phorton1/Arduino-bilgeAlarm/docs/drawings/bilge2.jpg

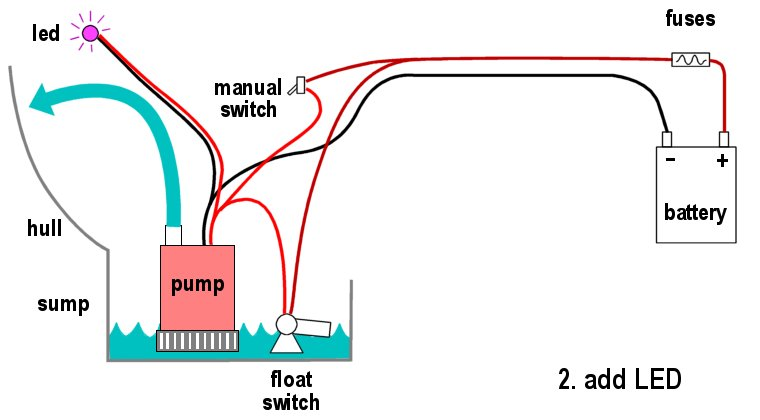
docs/drawings/bilge2.jpg
