phorton1/Arduino-bilgeAlarm/docs/drawings/bilge3.jpg

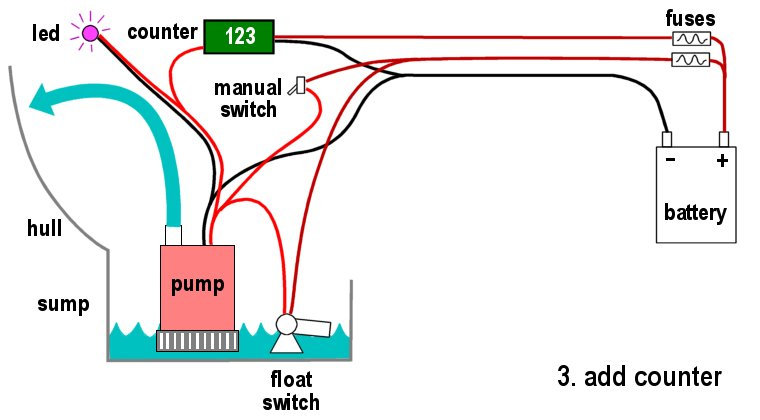
docs/drawings/bilge3.jpg
