phorton1/Arduino-bilgeAlarm/docs/drawings/bilge4.jpg

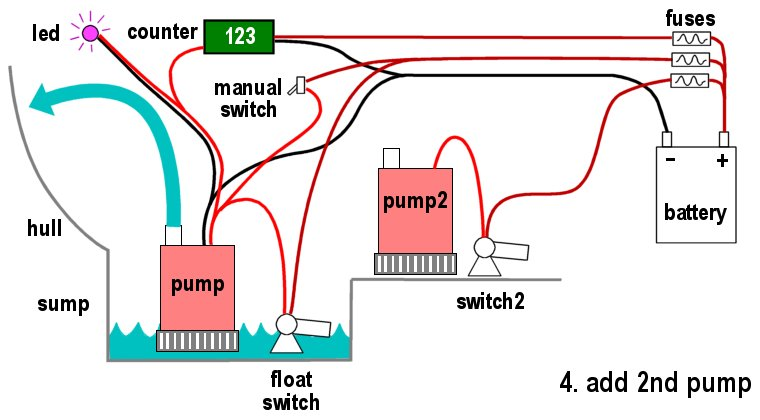
docs/drawings/bilge4.jpg
