phorton1/Arduino-bilgeAlarm/docs/lightburn/face.dxf

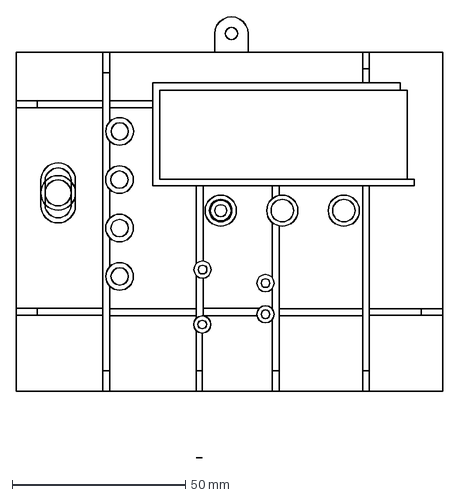
[picture p13: CAD file, 2023-01-15]
docs/lightburn/face.dxf
123.2 x 127.7 mm
