phorton1/Arduino-bilgeAlarm/docs/prusa/alarm_support.3mf

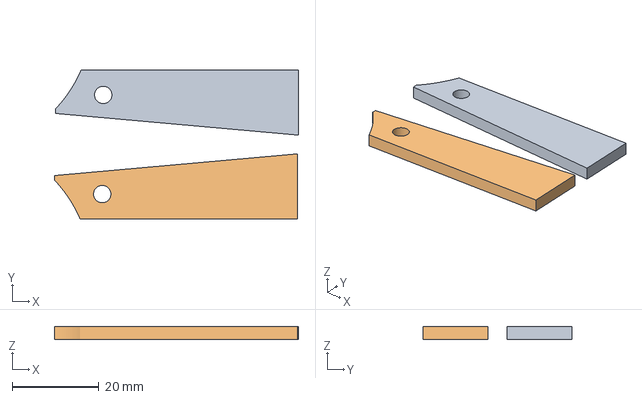
[picture p14: CAD file, 2023-01-15]
docs/prusa/alarm_support.3mf
56.2 x 34.3 x 3.00 mm
alarm_support.stl x 2
