phorton1/Arduino-bilgeAlarm/docs/stl/button.stl

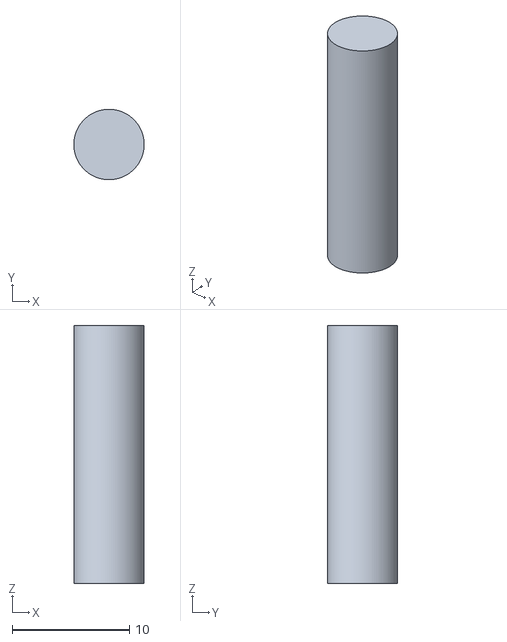
[picture p15: CAD file, 2023-01-15]
docs/stl/button.stl
6.00 x 6.00 x 22.0
