phorton1/Arduino-bilgeAlarm/docs/prusa/led_lens.3mf

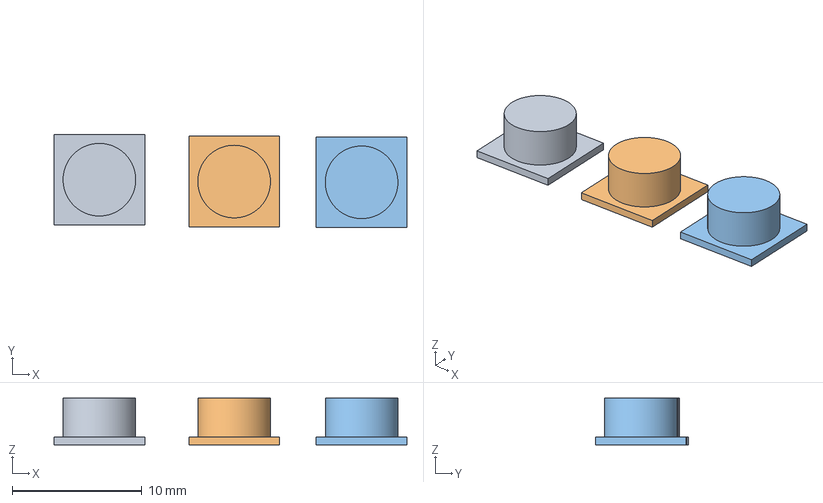
[picture p16: CAD file, 2023-01-15]
docs/prusa/led_lens.3mf
27.2 x 7.20 x 3.60 mm
led_lens.stl x 3
