phorton1/Arduino-bilgeAlarm/docs/stl/led_lens.stl

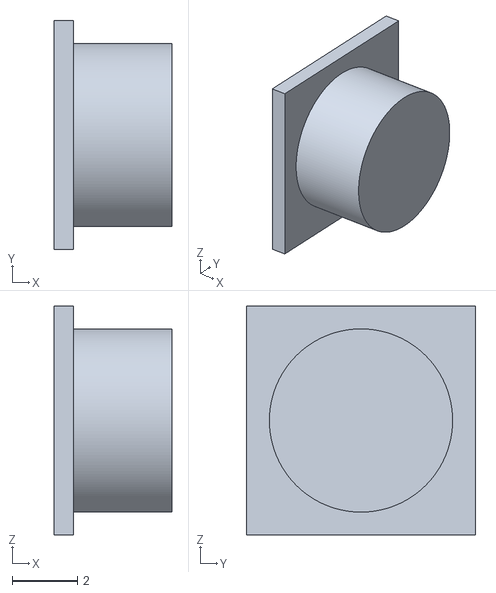
[picture p17: CAD file, 2023-01-15]
docs/stl/led_lens.stl
3.60 x 7.00 x 7.00
