phorton1/Arduino-bilgeAlarm/docs/prusa/led_body.3mf

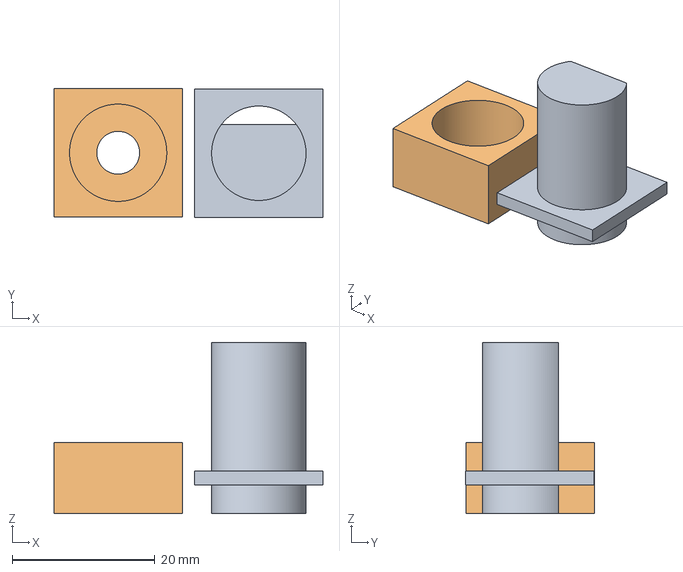
[picture p18: CAD file, 2023-01-15]
docs/prusa/led_body.3mf
37.7 x 18.1 x 24.0 mm
led_body.stl
led_cap.stl
