phorton1/Arduino-bilgeAlarm/docs/stl/usb_mount.stl

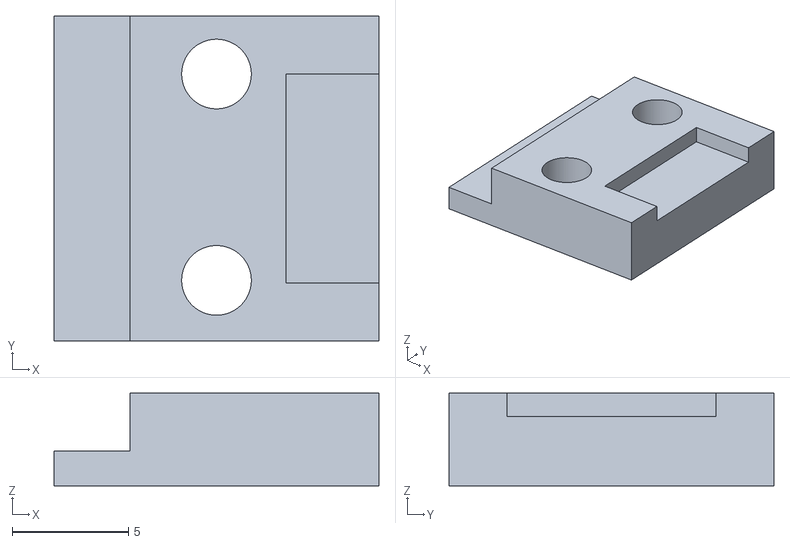
[picture p19: CAD file, 2023-01-15]
docs/stl/usb_mount.stl
14.0 x 14.0 x 4.00
