phorton1/Arduino-bilgeAlarm/docs/prusa/base.3mf

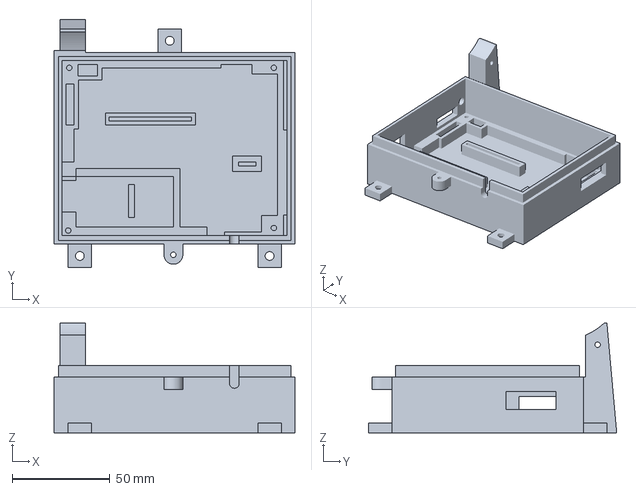
[picture p20: CAD file, 2023-01-15]
docs/prusa/base.3mf
123.2 x 127.0 x 56.0 mm
