phorton1/Arduino-bilgeAlarm/docs/prusa/toppers.3mf

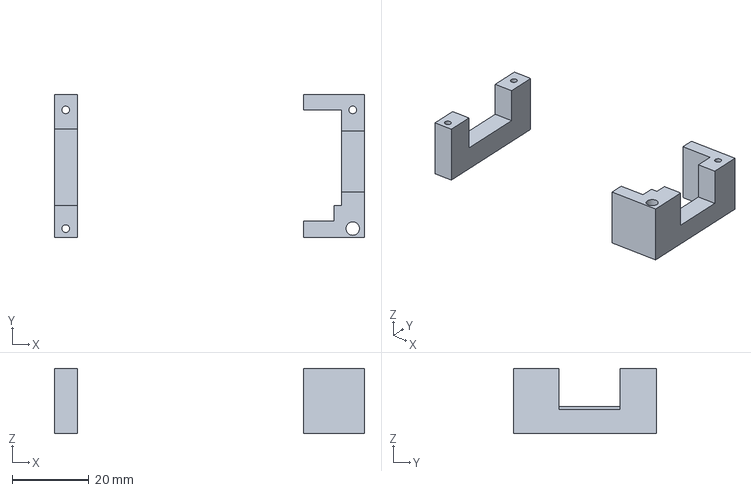
[picture p21: CAD file, 2023-01-15]
docs/prusa/toppers.3mf
81.0 x 37.3 x 17.0 mm
