phorton1/Arduino-bilgeAlarm/docs/stl/led_body.stl

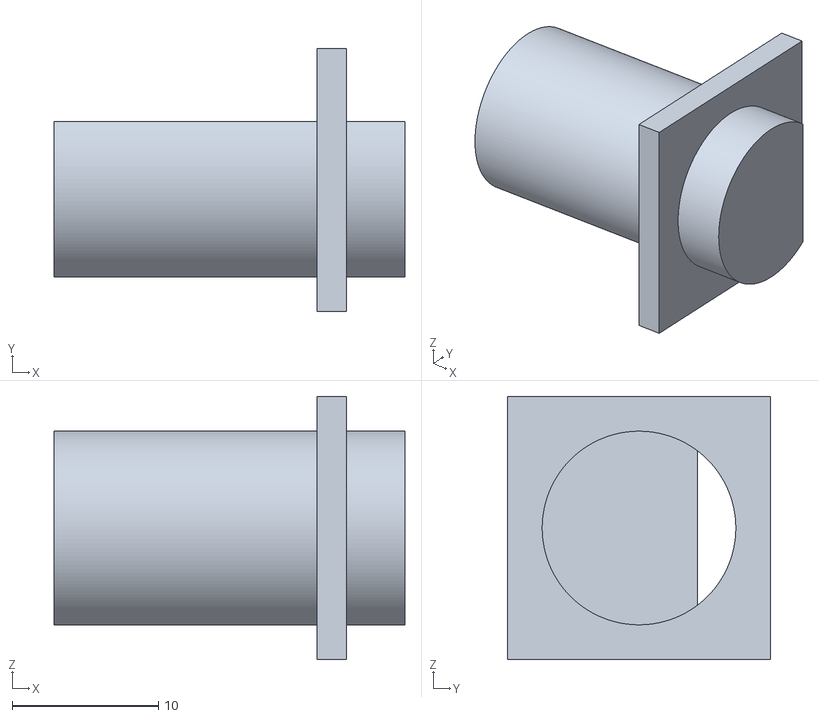
[picture p22: CAD file, 2023-01-15]
docs/stl/led_body.stl
24.0 x 18.0 x 18.0
