phorton1/Arduino-bilgeAlarm/docs/prusa/button.3mf

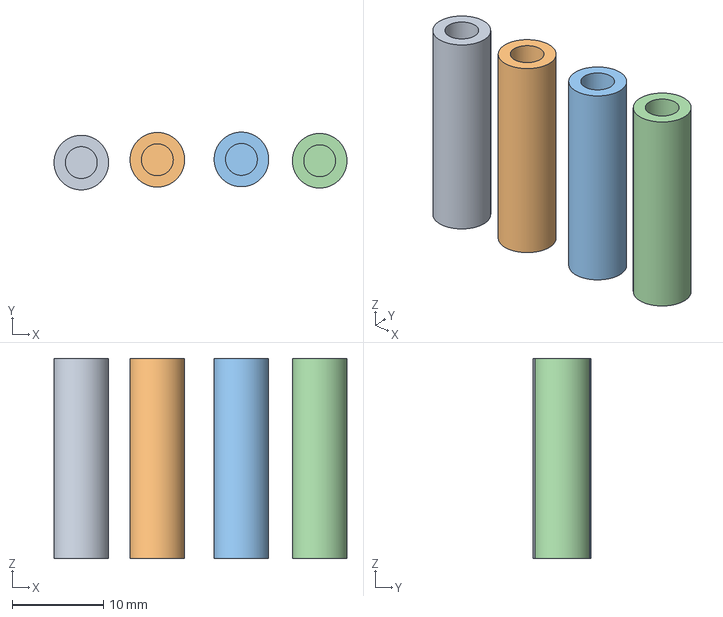
[picture p23: CAD file, 2023-01-15]
docs/prusa/button.3mf
32.2 x 6.35 x 22.0 mm
button.stl x 4
