phorton1/Arduino-bilgeAlarm/docs/prusa/face.3mf

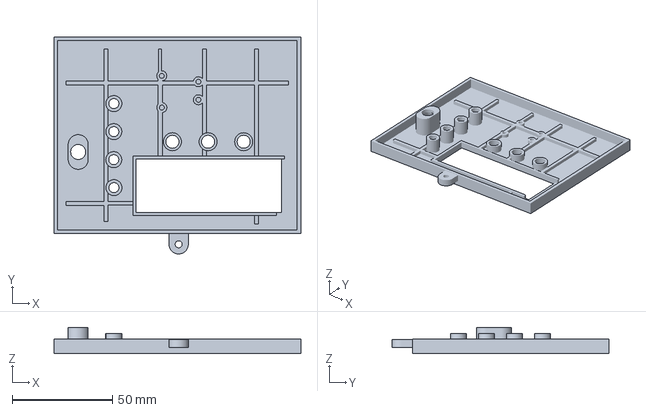
[picture p24: CAD file, 2023-01-15]
docs/prusa/face.3mf
123.2 x 108.2 x 13.0 mm
