phorton1/Arduino-bilgeAlarm/docs/stl/led_cap.stl

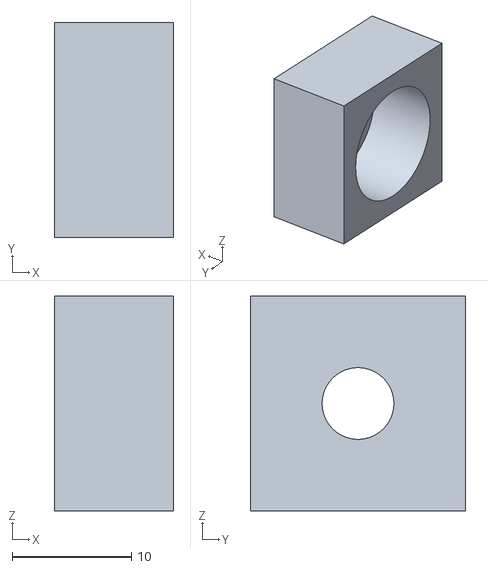
[picture p25: CAD file, 2023-01-15]
docs/stl/led_cap.stl
10.0 x 18.0 x 18.0
