phorton1/Arduino-bilgeAlarm/docs/stl/alarm_support.stl

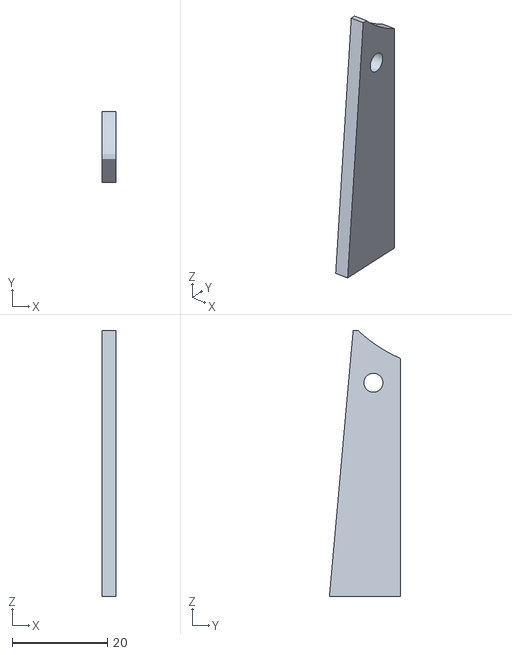
[picture p26: CAD file, 2023-01-15]
docs/stl/alarm_support.stl
3.00 x 15.0 x 56.0
