phorton1/Arduino-bilgeAlarm/(list of files, cad)

Other CAD files:
docs/stl/base.stl
docs/stl/pcb_topper.stl
docs/stl/face.stl
docs/fusion/external_led_holder v3.f3d
