phorton1/Arduino-bilgeAlarm/docs/kiCad/board/bilgeAlarm.kicad_pcb

## KiCad design docs/kiCad/board/bilgeAlarm.kicad_pcb (2023-01-15)

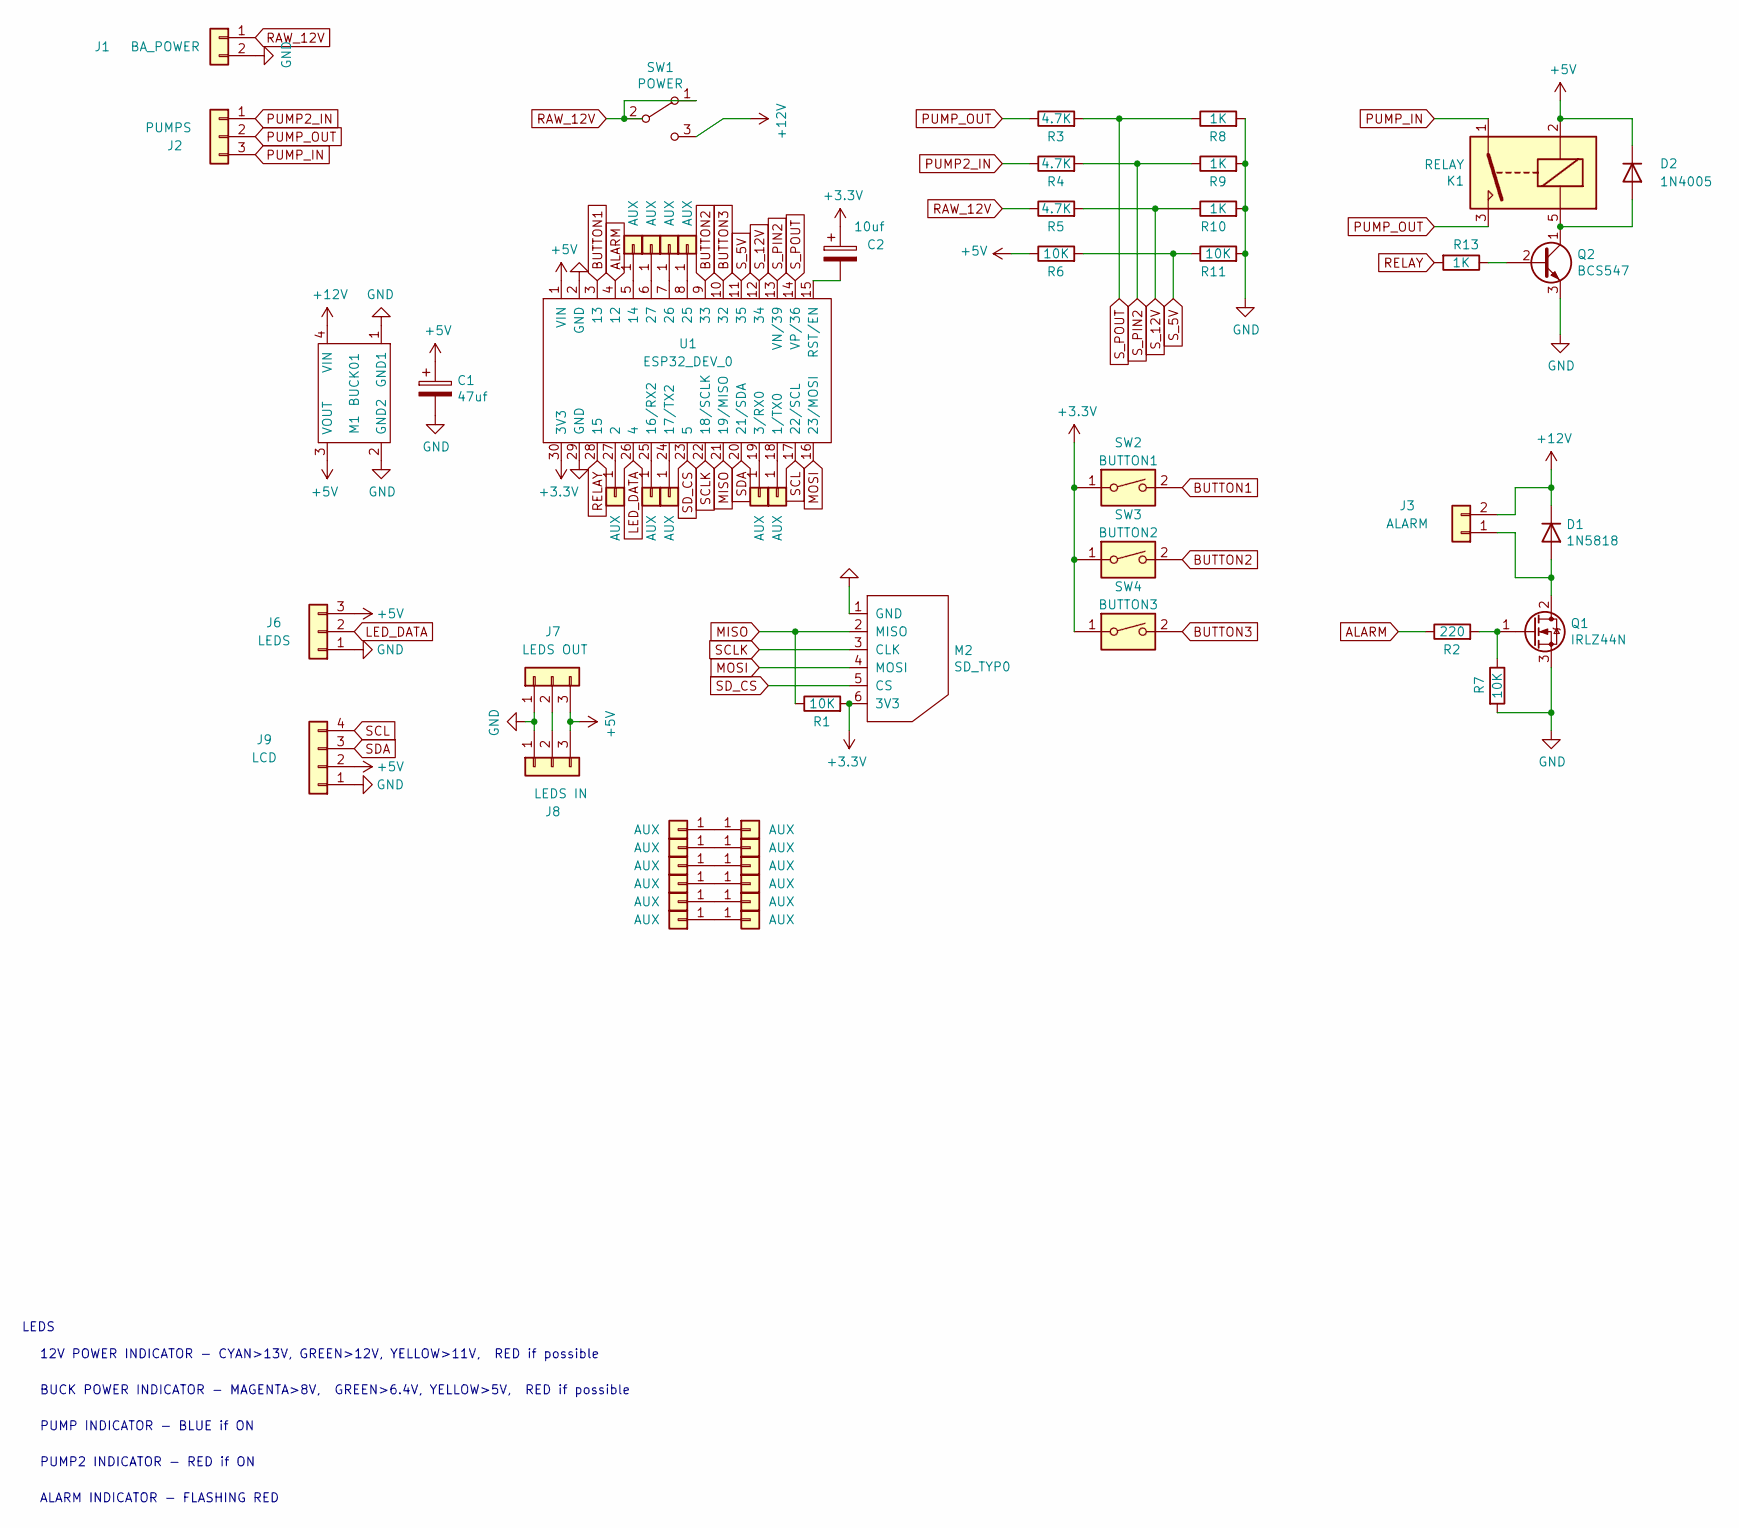
[picture p32: schematic bilgeAlarm.sch]

Parts:
C1: 47uf; CP_my100uf
C2: 10uf; CP_my10uf
D1: 1N5818; myDiodeSchotsky
D2: 1N4005; myDiodeSchotsky
J1: BA_POWER; myTerminalBlock_5.08x02
J2: PUMPS; myTerminalBlock_5.08x03
J3: ALARM; myTerminalBlock_5.08x02
J6: LEDS; myPinSocket_1x03
J7: LEDS OUT; myPinSocket_1x03
J8: LEDS IN; myPinSocket_1x03
J9: LCD; myPinSocket_1x04
J21, J22, J23, J24, J25, J26, J27, J28, J29, J30, J31, J32, J33, J34, J35, J36, J37, J38, J39, J40, J41: AUX; my1pin
K1: RELAY; myRelay
M1: BUCK01; myMini360BuckConverter
M2: SD_TYP0; SDCardReader
Q1: IRLZ44N; myTO-220-3
Q2: BCS547; my3pin
R1, R6, R7, R11: 10K; myResistor
R2: 220; myResistor
R3, R4, R5: 4.7K; myResistor
R8, R9, R10, R13: 1K; myResistor
SW1: POWER; mySwitchToggleSPDT
SW2: BUTTON1; myButton
SW3: BUTTON2; myButton
SW4: BUTTON3; myButton
U1: ESP32_DEV_0; myESP32DEV0

Connections:
+3V3: C2.1, M2.6 (3V3), R1.2, SW2.1, SW3.1, SW4.1, U1.30 (3V3)
+5V: C1.1, D2.1 (K), J6.3, J7.3, J8.3, J9.2, K1.2, M1.3 (VOUT), R6.1, U1.1 (VIN)
+12V: D1.1 (K), J3.2, M1.4 (VIN), SW1.3 (C)
ALARM: R2.1, U1.4 (12)
BUTTON1: SW2.2, U1.3 (13)
BUTTON2: SW3.2, U1.9 (33)
BUTTON3: SW4.2, U1.10 (32)
GND: C1.2, J1.2, J6.1, J7.1, J8.1, J9.1, M1.1 (GND1), M1.2 (GND2), M2.1 (GND), Q1.3 (S), Q2.3 (E), R7.2, R8.2, R9.2, R10.2, R11.2, U1.2 (GND), U1.29 (GND)
LED_DATA: J6.2, U1.26 (4)
MISO: M2.2 (MISO), R1.1, U1.21 (19/MISO)
MOSI: M2.4 (MOSI), U1.16 (23/MOSI)
unnamed: C2.2, U1.15 (RST/EN)
unnamed: D1.2 (A), J3.1, Q1.2 (D)
unnamed: D2.2 (A), K1.5, Q2.1 (C)
unnamed: J7.2, J8.2
unnamed: J21.1, U1.27 (2)
unnamed: J22.1, U1.25 (16/RX2)
unnamed: J23.1, U1.24 (17/TX2)
unnamed: J24.1, U1.5 (14)
unnamed: J25.1, U1.7 (26)
unnamed: J26.1, U1.8 (25)
unnamed: J27.1, U1.19 (3/RX0)
unnamed: J28.1, U1.18 (1/TX0)
unnamed: J29.1, U1.6 (27)
unnamed: J30.1, J36.1
unnamed: J31.1, J37.1
unnamed: J32.1, J38.1
unnamed: J33.1, J39.1
unnamed: J34.1, J40.1
unnamed: J35.1, J41.1
unnamed: Q1.1 (G), R2.2, R7.1
unnamed: Q2.2 (B), R13.1
PUMP2_IN: J2.1, R4.1
PUMP_IN: J2.3, K1.1
PUMP_OUT: J2.2, K1.3, R3.1
RAW_12V: J1.1, R5.1, SW1.1 (A), SW1.2 (B)
RELAY: R13.2, U1.28 (15)
SCL: J9.4, U1.17 (22/SCL)
SCLK: M2.3 (CLK), U1.22 (18/SCLK)
SDA: J9.3, U1.20 (21/SDA)
SD_CS: M2.5 (CS), U1.23 (5)
S_5V: R6.2, R11.1, U1.11 (35)
S_12V: R5.2, R10.1, U1.12 (34)
S_PIN2: R4.2, R9.1, U1.13 (VN/39)
S_POUT: R3.2, R8.1, U1.14 (VP/36)

Notes on the sheet:
LEDS
12V POWER INDICATOR - CYAN>13V, GREEN>12V, YELLOW>11V, RED if possible
BUCK POWER INDICATOR - MAGENTA>8V, GREEN>6.4V, YELLOW>5V, RED if possible
PUMP INDICATOR - BLUE if ON
PUMP2 INDICATOR - RED if ON
ALARM INDICATOR - FLASHING RED

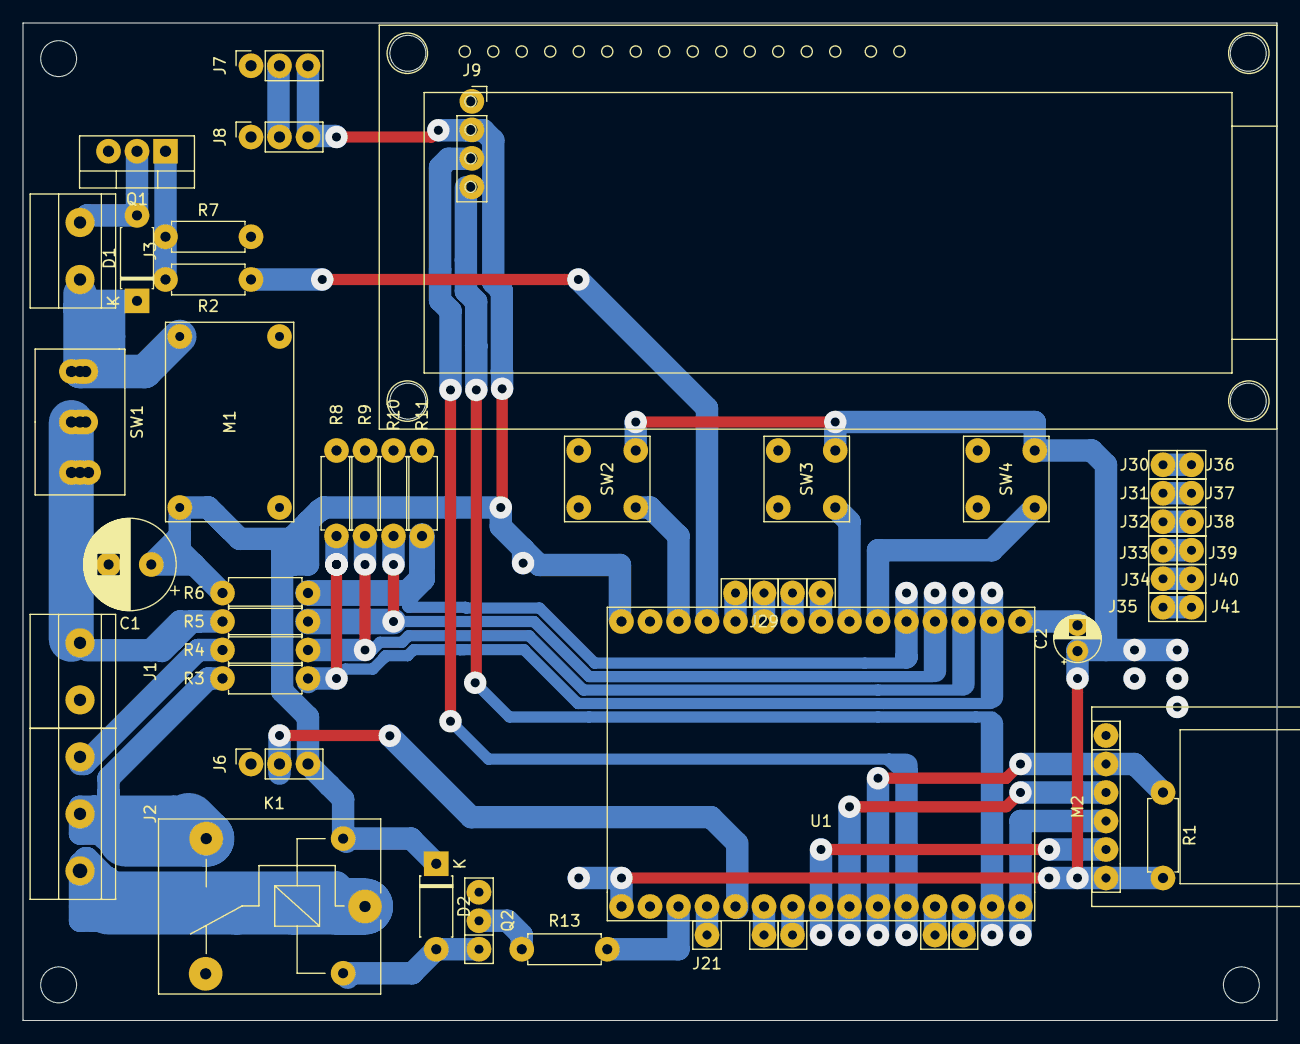
[picture p33: board bilgeAlarm.kicad_pcb from above]

Board: 2 copper layers, 111.8 x 88.9 mm, 54 parts (0 on the bottom side), 45 nets.
