phorton1/Arduino-bilgeAlarm/docs/kiCad/led_board/led_board.kicad_pcb

## KiCad design docs/kiCad/led_board/led_board.kicad_pcb (2022-02-03)

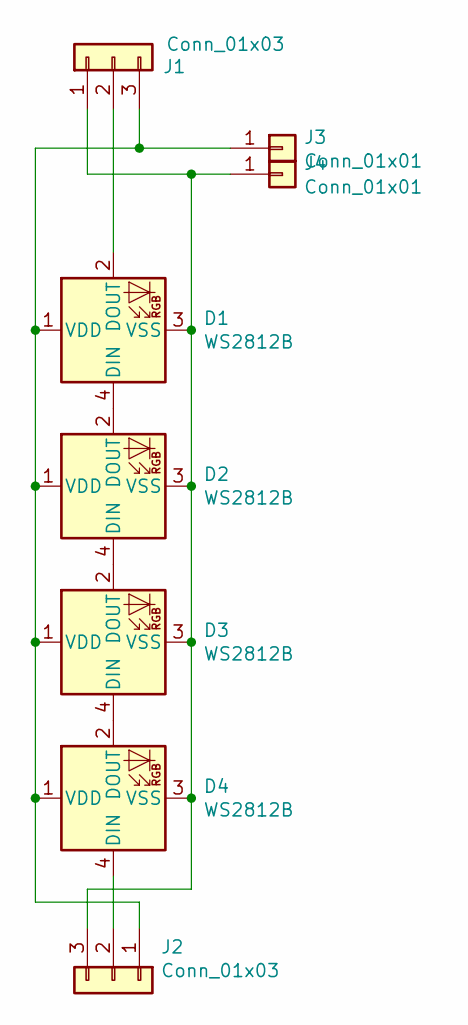
[picture p34: schematic led_board.sch]

Parts:
D1, D2, D3, D4: WS2812B; myWS2812
J1, J2: Conn_01x03; my3pin
J3, J4: Conn_01x01; my1pin

Connections:
unnamed: D1.1 (VDD), D2.1 (VDD), D3.1 (VDD), D4.1 (VDD), J1.3, J2.1, J3.1
unnamed: D1.2 (DOUT), J1.2
unnamed: D1.3 (VSS), D2.3 (VSS), D3.3 (VSS), D4.3 (VSS), J1.1, J2.3, J4.1
unnamed: D1.4 (DIN), D2.2 (DOUT)
unnamed: D2.4 (DIN), D3.2 (DOUT)
unnamed: D3.4 (DIN), D4.2 (DOUT)
unnamed: D4.4 (DIN), J2.2

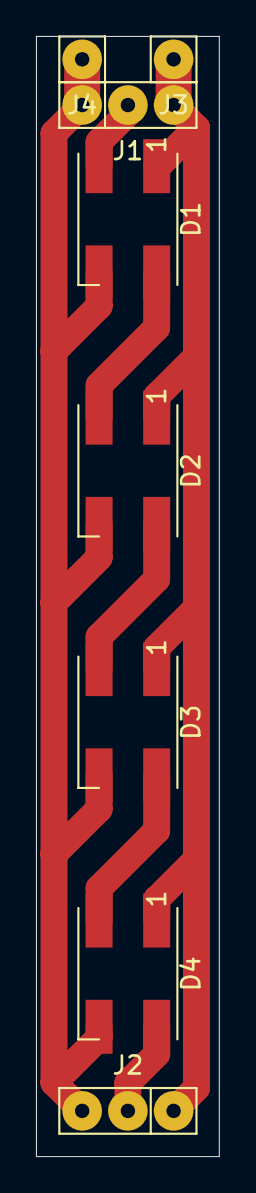
[picture p35: board led_board.kicad_pcb from above]

Board: 2 copper layers, 10.2 x 62.2 mm, 8 parts (0 on the bottom side), 7 nets.
