phorton1/Arduino-bilgeAlarm/bilgeAlarm.ino

//-----------------------------------
// bilgeAlarm.ino
//-----------------------------------

#include "bilgeAlarm.h"
#include "baAlarm.h"      // for showIncSetupPixel()
#include <myIOTLog.h>

#if WITH_SD
    #define INIT_SD_EARLY 1
#endif


//--------------------------------
// main
//--------------------------------


void setup()
{
    initPixels();

    Serial.begin(MY_IOT_ESP32_CORE == 3 ? 115200 : 921600);
    delay(1000);

    bilgeAlarm::setDeviceType(BILGE_ALARM);
    bilgeAlarm::setDeviceVersion(BILGE_ALARM_VERSION);
    bilgeAlarm::setDeviceUrl(BILGE_ALARM_URL);

    // init the SD Card early in derived device
    // due to it's wonky SPI behavior, and so that
    // logfile can begin immediately.

    #if WITH_SD
    #if INIT_SD_EARLY
        bool sd_ok = 0;
        int init_count = 0;
        while (!bilgeAlarm::hasSD() && init_count++ < 10)
        {
            bilgeAlarm::initSDCard();
            if (!bilgeAlarm::hasSD())
                LOGD("initSDCard() EARLY fail(%d)",init_count);
            delay(700);
        }
    #endif
    #endif

    LOGU("");
    LOGU("");
    LOGU("bilgeAlarm.ino setup() started on core(%d)",xPortGetCoreID());

    showIncSetupPixel();    // 0

    #if WITH_SD
    #if INIT_SD_EARLY
        LOGU("sd_ok=%d init_count=%d",sd_ok,init_count);
        delay(200);
    #endif
    #endif

    bilge_alarm = new bilgeAlarm();
    bilge_alarm->setup();


        // 1,2,3 is IOTDevice.
        // 4 is probably this one
        // and 5 is probably the alarmTask starting up
        // then they go off

    LOGU("bilgeAlarm.ino setup() finished",0);
}



void loop()
{
    bilge_alarm->loop();
}
