phorton1/Arduino-bilgeAlarm/(commit log)

2021-11-09 servoTest, esp32Camera, begin new bilgeAlarm architecture
2021-11-19 Captive Portal WIP - added preferences
    [partitions.csv]
2021-11-25 initial Bootstrap WebUI with SPIFFS upload - PROBLEM WITH TOP BYTES OF FLASH using 'default' partition table - MODIFIED default.csv in /Users/Patrick/Adrduino/blah to NOT USE top 2K of FLASH
    [partitions.csv]
2021-11-29 barely working webUI topic switch
2021-11-29 added keyboardTask, MQQTConnectTask, basicOTA, and broke my css and js out of data/index.html
    [bilgeAlarm2.ino]
2021-11-30 rudimentary WebUI ws re-open strategy; random LED changes
2021-12-04 added SD Card, memory in log messages, and git_ignore arduino/libraries/esp32_sqlite
2021-12-09 rudimentary power logging; added LOGXXX to WebUI console
2021-12-10 playing with power monitoring, OTA, and hiding passwords
2021-12-13 reworked 'elements' into 'values' with general cleanup
    [bilgeAlarm2.ino]
2021-12-14 fuss with webUI error handling (focus) and propogating value errors from the server
    [bilgeAlarm2.ino]
2021-12-23 final Arduino bilgeAlarm and myIOT library before breakout - added liquid crystal, more members, prep for state machine
2021-12-23 add docs/kiCad
    [bilgeAlarm.kicad_pcb, bilgeAlarm.sch]
2021-12-24 generate flatcam gcode files
    [bilgeAlarm.kicad_pcb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]
2021-12-28 added WS task, ferreted out LCD multi-core problem, tested VPN stuff
    [bilgeAlarm.cpp, bilgeAlarm.h, bilgeAlarm.ino]
2022-01-07 BIG COMMIT - added device_list to iotServer UI (multiple devices); added REBOOT and ws_closed disabling UI; added miami server user myiot_user and SSH keys for port forwarding; added working rPi serv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
    [bilgeAlarm.cpp]
2022-01-09 implement bilgeAlarm counting errors - still need javascript
    [bilgeAlarm.cpp, bilgeAlarm.h, bilgeAlarm.ino]
2022-01-10 bilgeAlarm time and time_since & javascript; added IP address to device; renamed dash/device/system UI to dash/config/device
2022-01-12 initial LCD ui - cleaned up count error clearing
    [bilgeAlarm.cpp, bilgeAlarm.h]
2022-01-13 factored bilgeAlarm.cpp into baRuns and baAlarm, changed baScreen/baButton to uiScreen/uiButton, implemented emergency alarm also gets counts, fixed UI duration display
    [partitions.csv]
2022-01-13 made stateMachine() task, publish in loop(), reworked counter logic, added error flags to history
    [baAlarm.cpp, baRuns.cpp, bilgeAlarm.cpp, bilgeAlarm.h, uiButtons.cpp, uiButtons.h, uiScreen.cpp]
2022-01-14 reworked durations with regards to relay and started counts immediately
    [baRuns.cpp, bilgeAlarm.cpp, bilgeAlarm.h, uiButtons.cpp, uiButtons.h, uiScreen.cpp, uiScreen.h]
2022-01-15 completed LCD DEVICE and CONFIG value UI & moved some docs around, got rid of build directory
    [partitions.csv]
2022-01-18 implemented bilgeAlarm ws2812b LEDS (which also caused reworking some of the state logic and logging)
    [baAlarm.cpp, bilgeAlarm.cpp, bilgeAlarm.h, bilgeAlarm.ino, uiScreen.cpp]
2022-01-20 minor final changes before printing bilgeAlarm PCB
    [bilgeAlarm.kicad_pcb]
2022-01-20 generate bilgeAlaram gcode
    [bilgeAlarm.kicad_pcb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]
2022-01-22 reworked bilgeAlarm gcode
    [bilgeAlarm.kicad_pcb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]
2022-01-24 additional gcode files for ill-fated, but nearly completed PCB
2022-01-26 minor changes to bilgeAlarm PCB gcode
2022-01-26 final bilgeAlarm PCB 1.0
    [bilgeAlarm.sorted.drl]
2022-01-29 use analogRead and pump switch thresholds to avert alarm cycling
2022-01-29 added 12V and 5V power monitoring - note that 12V is measuring MAIN power and NOT the PUMP1 IN like would make sense
2022-01-29 create led_board PCB
    [led_board.kicad_pcb, led_board.sch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]
2022-01-30 bilgeAlarm led_board v2
    [led_board.kicad_pcb, led_board.sch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]
2022-01-31 finish LED_BOARD, rework pixels at statrtup
    [baAlarm.cpp, bilgeAlarm.cpp, bilgeAlarm.ino, uiScreen.cpp]
2022-02-03 built box, added SelfTest
    [bilgeAlarm.kicad_pcb, led_board.kicad_pcb]
2022-02-03 fix mod error in history since calculation
    [baHistory.cpp]
2022-02-04 added VERBOSE and IOT_STYLE_VERBOSE for certain (POWER_12V) value changes to prevent them from showing in log files and added REFRESH button for SD Card UI
    [bilgeAlarm.cpp, uiButtons.cpp]
2022-02-05 cleanup startup LEDs and remove pump from selfTest (as it upsets actual pump statistics)
2022-03-12 added !!emergency_relay_on to count_this_run if statement to try to avoid spurious history entry after running emerrgency relay AND turned off emergency relay in my config AND changed _disabled to tr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
    [baAlarm.cpp, bilgeAlarm.cpp, bilgeAlarm.h]
2022-09-12 prep for BOARD2 - create copy of kiCad docs
    [bilgeAlarm.kicad_pcb, bilgeAlarm.sch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]
2023-01-01 got rid of docs/kicad *board2* folder and renamed "board1" to "board"
    [bilgeAlarm.kicad_pcb, bilgeAlarm.sch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]
2023-01-08 NO CHANGES - added a system schematic and turned on PCB layers to view
    [bilgeAlarm.kicad_pcb, system.kicad_pcb, system.sch]
2023-01-08 WIP - documentation - is forcing review of LCD/button UIs
2023-01-15 kicad - commit reworked PCB board using my new symbols and 3d footprints
    [bilgeAlarm.kicad_pcb, bilgeAlarm.sch]
2023-01-15 added 3D printing/drawing files
    [alarm_support.3mf, alarm_support.stl, base.3mf, base.stl, button.3mf, button.stl, external_led_holder v3.f3d, face.3mf]
2023-01-16 clarified ui modes && button semantics
2023-04-18 oops - changed 12V to VALUE_STYLE_READONLY
2023-07-08 added ID_DEVICE_URL (link to github device repository) to SSDP and WebUI
2024-03-19 turn of PUMP1_ON state when turning off RELAY_ON to prevent endless loops of DELAYED_RELAYS - also cleaned up the debugging a bit
    [bilgeAlarm.cpp]
2024-03-23 fix and DEBUG switch debounce_times
    [bilgeAlarm.cpp]
2024-09-21 submodule(data) auto_commit(83767cf1) Added a Widget tab to the main myIOT webpage; added jqplot CSS and JS files; wrote iotPlot.js prototype of charting within a "widget" - see fridgeController chec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
2024-09-25 submodule(data) auto_commit(331f60b7) refined myIOT plotter with LEGENDS and using device specific PLOT_TYPES if available; theClock3 implementation of PLOT_CYCLES and PLOT_WAVES
2024-09-27 reworked bilgeAlarm to use simplified myIOTDataLog and rely on SD card. changed WIP fridgeController as a result
    [baHistory.cpp, baHistory.h, bilgeAlarm.cpp, bilgeAlarm.h, bilgeAlarm.ino, uiScreen.cpp, uiScreen.h]
2024-09-29 added prototype bilgeAlarm jqPlot Widget using added "alt_data_format" and custom chart_header and chart_data code in onCustomLink(). modified myIOT/data index.html, iotChart.js, and iotCommon.js
2024-09-29 submodule(data) auto_commit(416ed000) added prototype bilgeAlarm jqPlot Widget using added "alt_data_format" and custom chart_header and chart_data code in onCustomLink(). modified myIOT/data index.h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
2024-10-21 submodule(data) auto_commit(b811e3f8) move generic uiButtons to myIOTButtons; implement initial tempController uiScreen and PCB board(s)
2025-12-15 submodule(data) auto_commit(b649fc3a) iotChart.js - added scheme for setting device specific series colors
2025-12-18 submodule(data) auto_commit(1adaeb45) reworked iotChart.js incremental update scheme starting with Arduino-boat-drainPump
2025-12-18 submodule(data) auto_commit(b6ac0c88) starting in Arduino-boat-arirco, major rework of iotChart.js and how charts are implemented - use common chart.html instead of specific/extra_data/device_chart.h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
2025-12-18 submodule(data) auto_commit(a4e2ed81) change chart.html and iotChart.js to use and remove style "degree_hidden" for devices that chart things with degrees
2026-02-22 submodule(data) auto_commit(37a6a76c) added framework for chart.html to pass "data_name" to allow multiple charts per device; ALSO store most recent chart period in browser storage
2026-03-05 added "boat" to the myIOTDevice advertised SSDP device URL
2026-03-05 submodule(data) auto_commit(ecc76888) update myIOT data submodule readme.md to remove forward references to actual implmented device repos
2026-04-04 submodule(data) auto_commit(de0689cf) disable Scan/Delete endpoints and just View data records for devices that have graphs, but no SD card
2026-04-04 New Chart Tooltips and DataLog record maintenance feature in myIOT library and updated to all living devices appropriately
